museum-computer/Retro_plotter_XY4140/docs/схема1.jpg

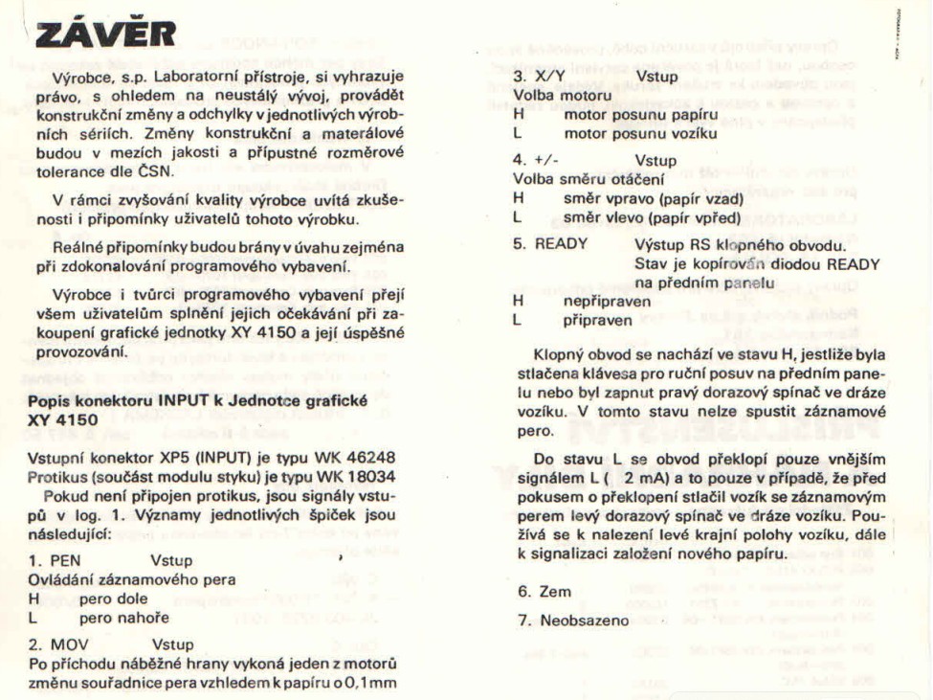
docs/схема1.jpg
