museum-computer/Retro_plotter_XY4140/docs/dsc_0014-1.webp

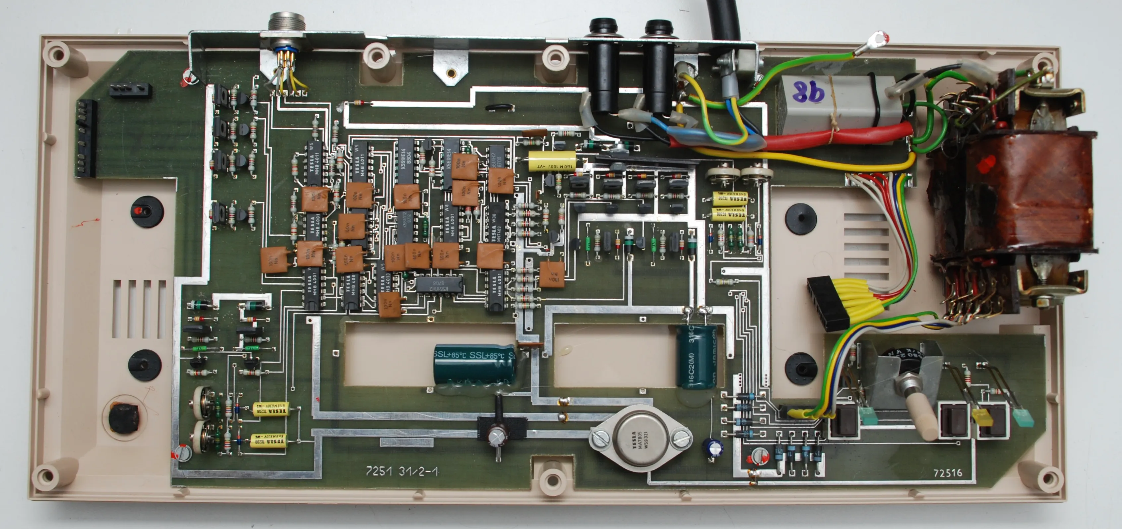
docs/dsc_0014-1.webp
