museum-computer/Retro_plotter_XY4140/README.md

# XY 4140 — печать векторных рисунков с microSD на Arduino Nano

Управление графопостроителем **XY 4140** (советский Kleinplotter, графическая приставка к robotron KC-87) с Arduino Nano: печать файлов HPGL с карты microSD, две кнопки, светодиод состояния. Без экрана, без логов, без шрифтов — только рисунок.

схема подключения

## Что получилось

| | |
|---|---|
| Платформа | Arduino Nano (ATmega328P, 5 В, 16 МГц), вариант «legacy» — прошивка загрузчиком 57600 бод |
| Управление | 6-контактный разъём XY 4140: PEN, STEP, X/Y, +/−, READY, GND |
| Разрешение | 1 шаг = 0,1 мм, поле 2600 × 1850 шагов (260 × 185 мм) — см. раздел «Калибровка» |
| Источник рисунков | microSD, SPI, только корень карты, порядок каталога |
| Формат | HPGL-подмножество: `IN`, `PA`, `PR`, `PU`, `PD`, `SP` |
| Органы управления | D8 = следующий рисунок, D9 = STOP, светодиод на A0 |
| Текущий режим | `SELFTEST_A 1` — при включении рисуется буква «A» и рамка поля, карта и кнопки не используются |
| Прошивка | 8604 байта Flash (28 %) в режиме проверки, 14 620 байт (47 %) в режиме печати с карты |

## Подключение

Полная схема — в [`docs/XY4140_wiring.pdf`](docs/XY4140_wiring.pdf) (страница 1 — схема, страницы 2–3 — таблицы и порядок проверки). Исходник схемы: `docs/wiring.html`.

| Пин Nano | Куда | Уровень |
|---|---|---|
| D2 | PEN (контакт 1) | LOW — перо вверх, HIGH — перо вниз |
| D3 | STEP (контакт 2) | каждый переход в LOW — один шаг 0,1 мм |
| D4 | X/Y (контакт 3) | LOW — ось CART/Y, HIGH — ось PAPER/X |
| D5 | +/− (контакт 4) | LOW — направление A, HIGH — направление B |
| D6 | READY (контакт 5) | выход через резистор 4,7 кОм: импульс LOW = запрос, HIGH = отпустить |
| D7 | READY (контакт 5) | вход с подтяжкой 10 кОм на GND: LOW = графопостроитель готов |
| GND | GND (контакт 6) | общая земля с графопостроителем и драйверами двигателей |
| D8 | кнопка NEXT на GND | покой → печать следующего файла, печать → прервать |
| D9 | кнопка STOP на GND | остановка, в том числе посреди длинной штриховки |
| A0 | светодиод + 1 кОм на GND | мигание: покой / печать / файл отпечатан / ошибка |
| D10…D13 | microSD: CS, MOSI, MISO, SCK | SPI, VCC = 5 В |
| 5V | питание Nano | 5 В стабилизированных, общая земля |

Подтяжка кнопок к 5 В включена программно (`INPUT_PULLUP`) — внешние резисторы не нужны. Сигналы Nano — 5 В TTL, подключаются к разъёму напрямую.

### Нумерация контактов разъёма

Нумерация контактов — сторона графопостроителя, а не разъёма LPT компьютера. Она одинакова для всей серии XY 4131 / 4140 / 4150:

| Контакт | Сигнал | Контакт LPT |
|---|---|---|
| 1 | PEN | 4 |
| 2 | STEP | 5 |
| 3 | X/Y | 3 |
| 4 | +/− | 2 |
| 5 | READY | 6 |
| 6 | GND | 18 |

Источник — проект [berk76/plottercontroller](https://github.com/berk76/plottercontroller), раздел 3.2.2, где приведена раскладка параллельного порта для трёх моделей. Родное руководство к прибору (`docs\Plotter XY 4140.pdf`, 43 страницы) электрической раскладки **не содержит** — только упоминание кабеля 536 648.1 и «Buchse für Computeranschluß».

Чего в документации нигде нет и что стоит проверить на самом приборе:

- **Направление счёта.** Ни в одном доступном источнике не сказано, с какой стороны и в какую сторону считать контакты: со стороны ответной части разъёма или со стороны кабеля, по часовой стрелке или против. Общее правило для круглых разъёмов — считать против часовой стрелки, глядя на разъём снаружи, но для конкретного экземпляра это нужно подтвердить.
- **Маркировка контакта 1.** Ищите ключ-выступ или более длинный контакт; он определяет начало отсчёта.
- **Тип разъёма** в документации не указан; определяется по корпусу (вероятно, 6-контактный круглый разъём типа DIN 45326 или VEB).

Как проверить без гадания, пока прибор в руках:

1. Выключить питание, отсоединить кабель.
2. Мультиметр в режиме сопротивления: найти провод, который меняет сопротивление при переключении тумблера PEN на корпусе — это контакт 1.
3. Провод заземления определяется по соединению с общей массой платы.
4. Остальные три (STEP, X/Y, +/−) проверяются по одному шагу при включённом питании и отключённом приводе: STEP даёт один импульс, X/Y и +/− задают ось и направление.

### Замеры на этом приборе

Эти данные сняты с прибора и имеют приоритет над таблицей выше.

| Что | Результат |
|---|---|
| Масса | **контакт 2**, а не 6, как в таблице от `berk76` |
| Сигналы | контакты 1, 3, 4, 5, 6 — все пять по **5 В** постоянки в покое |
| Уровни | интерфейс 5 В, а не 9 В — Nano подключается напрямую |
| Контакт 7 | не измерен |

Противоречие с документацией объяснимо тем, что в `berk76` приведена нумерация со стороны разъёма компьютера, а считать приходится со стороны графопостроителя. Если относительный порядок сигналов сохранился, а сдвиг отсчёта на единицу, то получаются две версии, и их различает только опыт:

| Контакт | Версия A | Версия B |
|---|---|---|
| 1 | — | PEN |
| 2 | GND | GND |
| 3 | PEN | READY |
| 4 | STEP | +/− |
| 5 | X/Y | X/Y |
| 6 | +/− | STEP |
| 7 | READY | — |

**Версии записаны как гипотезы, а не как результат.** Какая верная — определяется замером: на холостом ходу все линии стоят на 5 В, поэтому линия, которая начнёт щёлкать при подаче бумаги, и есть STEP.

Две меры безопасности, которые следуют из самого факта 5 В на всех линиях:

- **Не соединять два контакта разъёма между собой.** Обе линии уже сидят на 5 В от логики графопостроителя, так что мостик между ними это короткое на собственную шину +5 В прибора, а не на «ничего».
- На выходы Nano всё равно ставить последовательно 1 кОм, на вход D7 — резистор 10 кОм. При 5 В это формальность, но она спасает вывод при ошибке пайки.

Раньше 8–9 В наблюдались на трёх проводах, которые шли к доработанной плате. Это была её собственная шина, а не штатный интерфейс прибора.

Файл `docs\pinout.png` — не раскладка контактов прибора, а схема интерфейса для Raspberry Pi из того же стороннего проекта (файл побайтово совпадает с `docs/gfx/rpi_if.png` оттуда). Ориентироваться на него можно, но как на источник по заводу VEB он не годится.

## Поиск проводов на разъёме

Распиновка разъёма в таблице выше взята из чужого источника и **на этом экземпляре не проверена**. Если она не совпадает, провода ищутся скетчем `test_wires\test_wires.ino`: он не делает homing, не рисует и не требует нажимать кнопки.

**Скетч работает сразу после прошивки, обе руки свободны.** Кнопки не нужны и не задействованы. Перо всё время поднято, чтобы не поцарапать бумагу.

Что происходит без участия человека: программа гоняет каретку по циклу **CART назад, CART вперёд, PAPER назад, PAPER вперёд** и повторяет бесконечно. Каждый ход — 20 мм туда и 20 мм обратно, поэтому каретка возвращается на место и в упор не упирается. Между ходами пауза 1,2 с. Скорость шага 5 мс, то есть 0,1 мм за 10 мс — медленно и видно.

Отсюда порядок поиска, всё на ощупь и на глаз:

1. Найти три провода: STEP даёт импульсы, X/Y и +/− задают ось и направление. Массу определять по соединению с общей массой платы.
2. Прошить `test_wires.ino`. Ничего нажимать не надо.
3. Приложить предполагаемый STEP к **D3**. Если каретка поехала — это STEP. Если стоит — провод не тот, пробовать следующий.
4. Уже найденный STEP оставить на D3 и приложить следующий провод к **D4**. Каретка начнёт ездить то по бумаге, то по каретке — значит это X/Y.
5. Тот же провод оставить на D4, приложить третий к **D5**. Направление перестанет совпадать с ожидаемым — это +/−.

Каждый ход сопровождается строкой в Serial Monitor 115200 вида `chod 2 PAPER A -> ...`, так что видно, какая комбинация сейчас идёт и куда уехала каретка от включения.

### Поиск линии READY

Линия READY — единственная, где порядок не «провод приложили и посмотрели», а настоящий запрос-ответ, поэтому на неё ставят **сразу два провода**: **D6 и D7 на один и тот же контакт**. D6 задаёт запрос, D7 слушает ответ. Провод D6 обязательно через 4,7 кОм.

Зонд работает постоянно и печатает в порт только при изменении, так что лог не забивается:

```
RDY_IN pred dotykem = 0
RDY_IN zmena 0 -> 1   grafopstrojitar potvrdil LOW
```

Чтобы зонд шёл непрерывно, а не между ходами каретки, сначала остановить движение клавишей `m`.

**Не ждать от этого загорания индикатора.** Индикатор прибора загорается по своей внутренней логике, и как она связана с линией READY — неизвестно: распиновка и протокол handshake взяты из чужого источника и на этом экземпляре не подтверждены. Поэтому ориентироваться надо на цифру в логе, а лампу использовать как дополнительный признак.

Полезные команды, хотя искать можно без них:

| Клавиша | Действие |
|---|---|
| `m` | остановить или возобновить автоматический ход |
| `v` | разово вывести состояние пинов |
| `+` / `-` | сантиметр вручную по текущей ручной оси |
| `s` | один шаг 0,1 мм |
| `a` | переключить ручную ось CART/PAPER |
| `h` | homing, только после того как найден контакт READY |
| `p` | перо вверх или вниз |
| `z` | обнулить относительное начало |
| `?` | справка |

Ограничения скетча:

- Ход ограничен ±3 см от положения при включении — прибор не уедет за край поля, пока провода перепутаны. При попытке выйти за пределы скетч отменяет движение и пишет об этом в порт.
- Первые 6 с после перезагрузки скетч не двигает каретку, чтобы успеть убрать руки. Потом каретка может поехать сразу — это ожидаемо.
- «Влево-вправо» — это ось CART, потому что по руководству движение по X — это вращение роликов подачи бумаги, а по Y — перемещение каретки с пером. Если каретка едет по бумаге, значит X/Y подключены наоборот.
- Выключение — только тумблером сети графопостроителя, кнопки остановки нет.

## Установка

1. Скопировать папку `libraries\XY4140` в каталог `libraries` скетчбука Arduino IDE — либо указать скетчбук на корень этого проекта. Все скетчи используют `#include <XY4140.h>`.
2. Записать на карту файлы из `sd_card/` (короткие ASCII-имена: SD-библиотека открывает файлы по укороченному имени 8.3).
3. Прошить `test_wires.ino` и найти провода на разъёме, если распировка не подтверждена (раздел «Поиск проводов на разъёме»).
4. Прошить `xy4140_plotter.ino` — рабочая прошивка.
5. Перед первой печатью прошить `test_interface.ino` и пройти этапы 0–4 (раздел «Калибровка»).

Проверено с Arduino CLI, плата `arduino:avr:nano:cpu=atmega328old`, Arduino AVR Boards 1.8.7, библиотека SD — версия с новым API (`File entry = root.openNextFile();`):

```powershell
$cli = "C:\Program Files\Arduino CLI\arduino-cli.exe"
$lib = "C:\!GIT-PROJECTS\Plotter-XY 4140\libraries"
& $cli compile --fqbn arduino:avr:nano:cpu=atmega328old --libraries $lib --warnings all "C:\!GIT-PROJECTS\Plotter-XY 4140\xy4140_plotter"
& $cli compile --fqbn arduino:avr:nano:cpu=atmega328old --libraries $lib --warnings all "C:\!GIT-PROJECTS\Plotter-XY 4140\test_interface"
& $cli compile --fqbn arduino:avr:nano:cpu=atmega328old --libraries $lib --warnings all "C:\!GIT-PROJECTS\Plotter-XY 4140\test_wires"
```

## Структура проекта

```
libraries\XY4140\
  library.properties          метаданные библиотеки (architecture=avr, includes=XY4140.h)
  src\XY4140.h                API и пределы драйвера
  src\XY4140.cpp              протокол, шаги, homing, перемещения
test_interface\test_interface.ino     стендовый тест, Serial 115200, этапы 0–4
test_wires\test_wires.ino             поиск проводов на разъёме, без homing, Serial 115200
xy4140_plotter\xy4140_plotter.ino     рабочая прошивка: microSD + HPGL + кнопки
tools\make_samples.ps1                генератор 10 тестовых рисунков
sd_card\*.plt                         содержимое карты памяти
docs\XY4140_wiring.pdf                схема подключения и таблицы (3 страницы)
docs\wiring.html                      исходник схемы
docs\pinout.png                       распиновка
docs\Plotter XY 4140.pdf              руководство к прибору (оригинал)
```

## Проверка «буква A» (текущий режим)

`xy4140_plotter.ino` содержит режим самопроверки: при включении питания прошивка делает homing и рисует большую букву «A», затем рамку по краям поля. Ни карта памяти, ни кнопки в этом режиме не нужны — удобно проверить привод и геометрию, прежде чем подключать HPGL.

Включён константой `SELFTEST_A 1` в начале скетча:

```cpp
#define SELFTEST_A 1   // 1 = тест «A» при включении, 0 = печать HPGL с microSD
```

Что должно получиться на бумаге:

| Элемент | Координаты в шагах | Размер |
|---|---|---|
| буква «A» | (600, 150) … (2000, 1700) | ≈140 × 155 мм |
| рамка поля | (60, 60) … (2540, 1790) | отступ 6 мм от края |

Порядок работы: homing по CART (Y), затем «A», затем рамка. Светодиод горит постоянно во время отрисовки и мигает после завершения. Кнопка D9 прерывает тест в любой момент.

Что проверить по результату:

- буква не зеркальная и не перевёрнутая — иначе `DIR_INVERT 1`;
- буква не сжата по горизонтали — значит перепутаны X/Y, см. `SWAP_AXES`;
- рамка не упирается в края — измерить поля и поправить `MAX_X` / `MAX_Y` в `XY4140.h`;
- расстояние от края рисунка до края бумаги должно быть одинаковым по всем четырём сторонам.

Для перехода к печати с карты поставить `SELFTEST_A 0` и перепрошить. Больше ничего менять не нужно: чтение файлов, кнопки и парсер остаются в коде.

## Работа с прошивкой

Для режима печати с карты (`SELFTEST_A 0`):

Состояния и индикация:

| Светодиод | Состояние |
|---|---|
| вспышка 120 мс раз в 1,2 с | готов, ждём нажатия D8 |
| горит постоянно | печать файла |
| вспышка 120 мс, пауза 240 мс | файл отпечатан |
| вспышка 120 мс, пауза 120 мс | нет карты, нет файлов или ошибка открытия |

Кнопка D8 в покое запускает очередной файл. Каждый рисунок начинается с homing по оси CART (Y) до концевого выключателя. Кнопка D9 останавливает печать в любой момент, в том числе внутри длинной штриховки (проверка кнопки идёт прямо во время шагания).

Файлы берутся из корня карты в порядке каталога. Подкаталоги не просматриваются. Длинные имена и кириллица нежелательны.

### Настройки в `xy4140_plotter.ino`

| Константа | По умолчанию | Смысл |
|---|---|---|
| `DIR_INVERT` | 0 | 1 — если двигатели едут не в ту сторону |
| `USE_MAGNET` | 1 | 1 — перо прижимается магнитом, 0 — перо физически поднимается |
| `SPEED_US` | 1000 | длительность уровней LOW и HIGH на шаг, мкс. Шаг занимает `2 × SPEED_US`, то есть 1000 мкс дают ≈50 мм/с; паспортным 100 мм/с соответствует 500 |
| `PEN_SETTLE` | 10000 | пауза на переключение пера, мкс |
| `HOME_BACKOFF` | 50 | отход от концевого выключателя, шагов |
| `HOME_MAX` | 4000 | предел хода при homing, шагов |
| `SWAP_AXES` | 0 | 1 — рисунок транспонирован (185 × 261 мм вместо 260 × 185) |
| `X_FLIP` / `Y_FLIP` | 0 | зеркальное отражение по осям |
| `AUTO_ADVANCE` | 0 | 1 — печатать следующий файл автоматически |
| `SELFTEST_A` | 1 | 1 — при включении рисовать «A» и рамку, без карты и кнопок; 0 — обычная печать HPGL |
| `HPGL_UNITS_PER_STEP` | 4 | 1 HPGL-единица = 0,025 мм |

### Поддерживаемый HPGL

Принимаются: `IN` (инициализация, сбрасывает координаты в 0,0 и режимы), `PA` (абсолютные координаты), `PR` (относительные), `PU` (поднять перо), `PD` (опустить), `SP` (в этой прошивке `SP1` трактуется как «перо опущено», `SP0` — «поднято»; номер пера не хранится). В одном приказе может быть сколько угодно пар координат — полилинии вида `PD100,100,200,200,300,100;` рисуются целиком. Числа со знаком и дробные, разделители `,` и `;`, переводы строк, регистр команд любой.

Не поддерживается: текст, шрифты, заливка, кривые Безье, `AA`/`EC`/`EA`, масштаб и поворот через `IP`/`SC`.

## Тестовые рисунки

Десять файлов в `sd_card/` генерируются скриптом — правки в самих `.plt` не нужны, меняйте генератор и перезапускайте:

```powershell
powershell -NoProfile -ExecutionPolicy Bypass -File "C:\!GIT-PROJECTS\Plotter-XY 4140\tools\make_samples.ps1"
```

| Файл | Что рисует |
|---|---|
| `01_frame.plt` | рамки поля и засечки по углам, средние линии |
| `02_grid.plt` | сетка 20 × 13 |
| `03_ruler.plt` | линейки по нижнему и левому краю, шаг 1 мм, деления 2/6/9 мм |
| `04_circle.plt` | концентрические окружности 10…90 мм |
| `05_spiral.plt` | архимедова спираль, два оборота |
| `06_lissajous.plt` | кривая Лиссажу 3:2 |
| `07_star.plt` | пяти- и семиконечная звезда |
| `08_hatch.plt` | штриховка под 45° внутри окружности |
| `09_sine.plt` | три синусоиды разной амплитуды |
| `10_sweep.plt` | строчная заливка всего поля + диагональ |

Первые два файла самые быстрые — начинайте с них, они показывают правильность ориентации и масштаба.

## Калибровка

Прошивка `test_interface.ino` (Serial 115200), кнопка D8 переключает этапы, D9 останавливает:

| Этап | Что проверяем | Что делать с результатом |
|---|---|---|
| 0 | светодиод, линия READY | если D7 не читается — проверить резисторы 4,7 кОм и 10 кОм |
| 1 | перо: три коротких LOW, затем 1,2 с HIGH | перо должно удерживаться магнитом; иначе поменять полярность PEN |
| 2 | homing по CART (Y) | ожидается ≈1850 шагов; >2500 — перепутаны X/Y; мало — концевик уже был в начале |
| 3 | прямоугольник 20 × 30 мм от дома | если зеркальный — `DIR_INVERT 1` |
| 4 | рамка по всему полю, шкала, круг, диагональ | замерить поля линейкой и поправить `MAX_X` / `MAX_Y` в `XY4140.h` |

Что известно и что нет:

- Паспорт прибора: 2550 × 1800 шагов (255 × 180 мм). В коде стоит 2600 × 1850 — расхождение снять замером на этапе 4.
- Ось X не имеет концевика. Homing выполняется только по CART, и после него X считается равным 0, поэтому перед печатью бумага должна стоять у левого исходного упора.
- Полярность направления на конкретном экземпляре не проверялась — она задаётся `DIR_INVERT`.
- Рисунки из архива 2018 года сделаны под поле 185 × 261 мм, для них нужен `SWAP_AXES 1`; собственные примеры генератора рассчитаны на прямое отображение.

## Пересборка схемы

`docs/XY4140_wiring.pdf` печатается из `docs/wiring.html` headless-браузером:

```powershell
& "C:\Program Files\Google\Chrome\Application\chrome.exe" --headless=new --disable-gpu --no-pdf-header-footer `
  "--print-to-pdf=C:\!GIT-PROJECTS\Plotter-XY 4140\docs\XY4140_wiring.pdf" `
  "file:///C:/!GIT-PROJECTS/Plotter-XY%204140/docs/wiring.html"
```

## Ограничения

- **Интерфейс 5 В TTL: сигналы 3,3 В без согласования работать не будут.** Уровень 5 В на всех линиях подтверждён замером на приборе, прямые 5 В от Arduino Nano годятся.
- Оси прижимаются к упорам прижимным усилием привода; область за пределами `MAX_X`/`MAX_Y` программа обрезает, а не запрещает.
- Каталог карты не сортируется — порядок печати задаёт файловая система.
- Печать только в режиме абсолютных координат после `IN`.
