museum-computer/Retro_plotter_XY4140/docs/htmlconvd-CfhMxL131x1.jpg

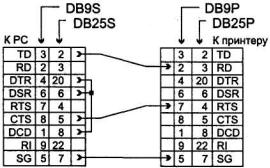
docs/htmlconvd-CfhMxL131x1.jpg
