museum-computer/Retro_plotter_XY4140/docs/htmlconvd-CfhMxL132x1.jpg

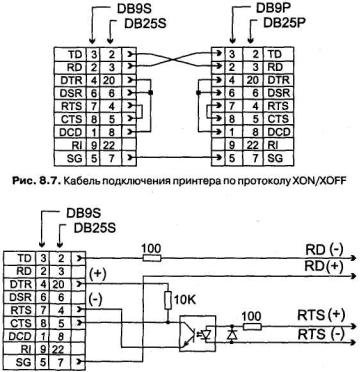
docs/htmlconvd-CfhMxL132x1.jpg
