museum-computer/Retro_plotter_XY4140/docs/iron-curtain-xy4150-adapter-for-atari.tif

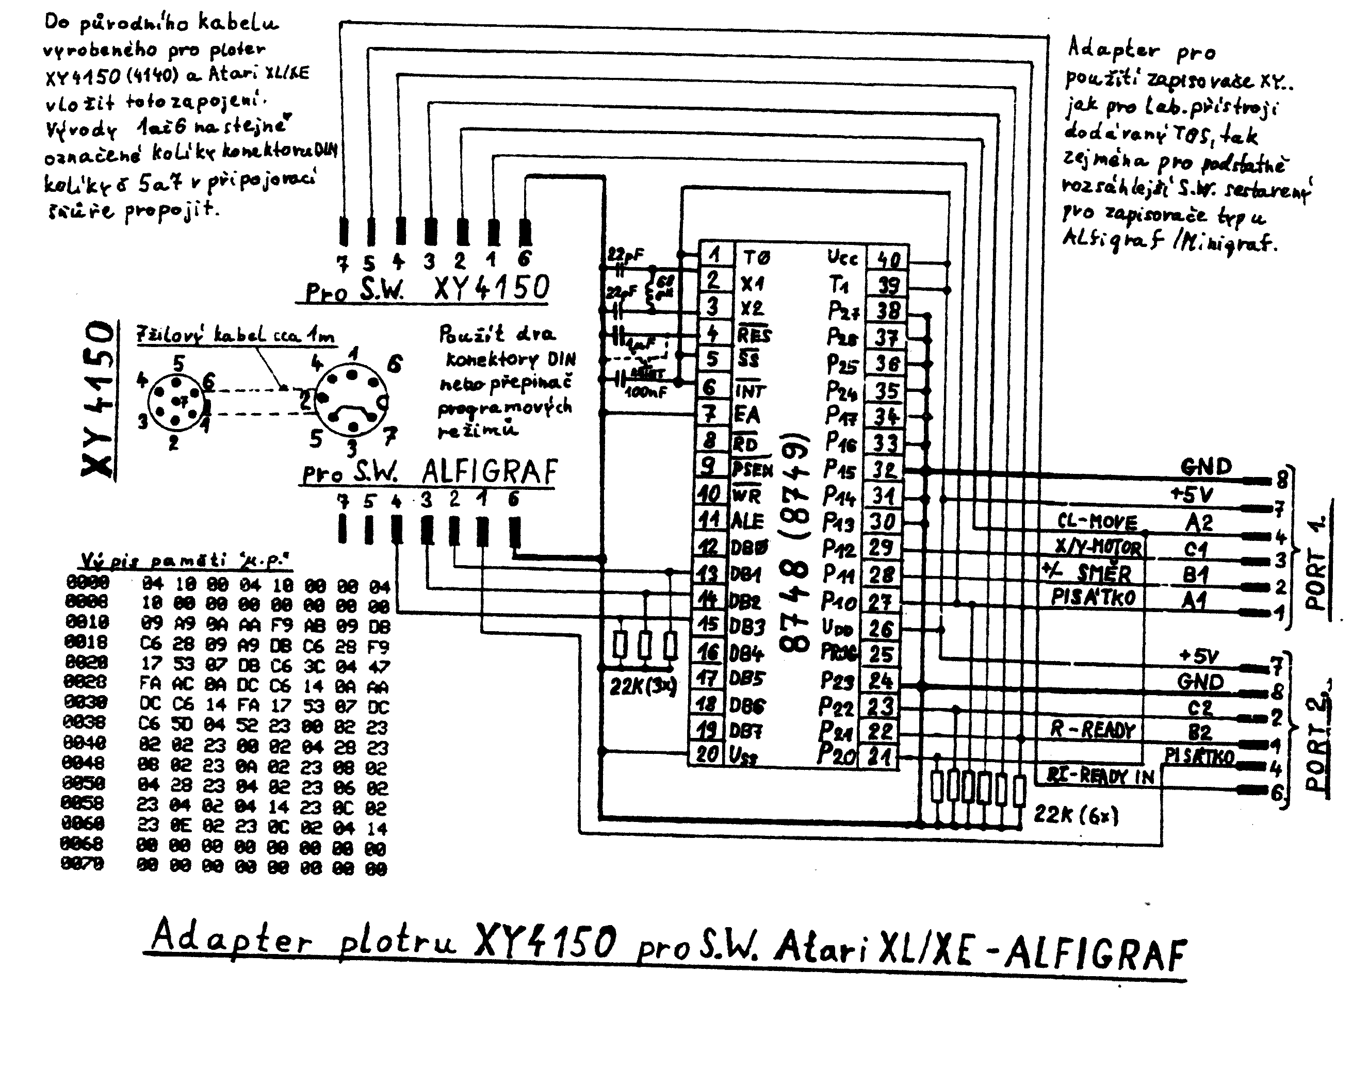
docs/iron-curtain-xy4150-adapter-for-atari.tif
