museum-computer/Retro_plotter_XY4140/docs/схема 2.jpg

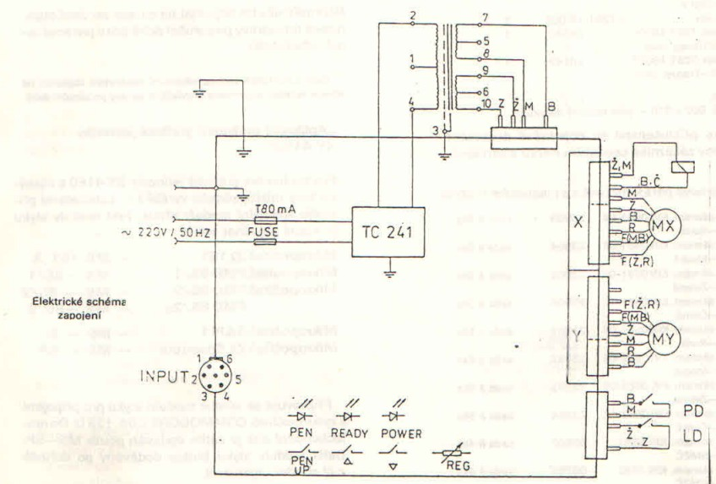
docs/схема 2.jpg
